EmbeddedSystemClass/FootlooseLogoController/SMC/ui.png

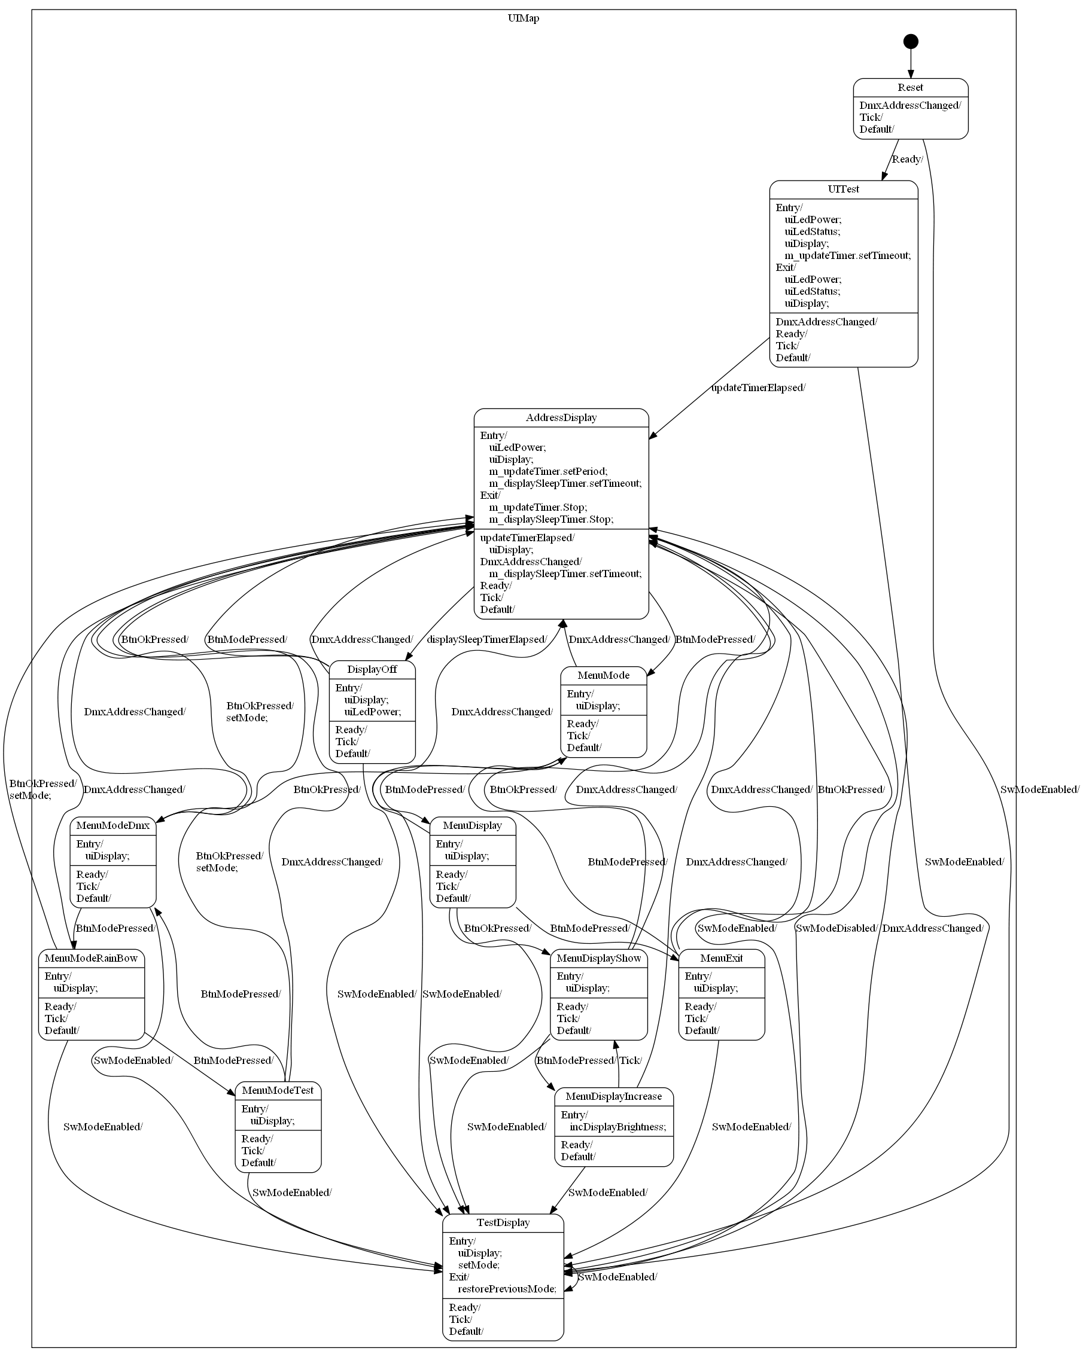
SMC/ui.png
