EmbeddedSystemClass/FootlooseLogoController/PCB/parts.xlsx

Sheet: controller
Partlist
Exported from controller pcb.sch at 25/02/2019 09:50
EAGLE Version 9.3.0 Copyright (c) 1988-2019 Autodesk, Inc.
Assembly variant:
Part | Value | Device | Package | Library | Sheet | farnell code | amount
C1, C2 | 22pF | C-EUC0603K | C0603K | rcl | 1 | 2533830
C3, C4, C5, C6, C7, C8, C12 | 100nF | C-EUC0603K | C0603K | rcl | 1 | 2522395
C9 | 2.2uF | C-EUC1206 | C1206 | rcl | 1 | 1458911
C10 | 22u | C-EUC1206 | C1206 | rcl | 1
C11 | No | C-EUC0603K | C0603K | rcl | 1
D1 | MBRA340T3 | MBRA340T3 | SMA | diode | 1
IC1, IC2, IC4 | MAX481CSA | MAX481CSA | SO08 | maxim | 1 | 2519249 (https://nl.farnell.com/maxim-integrated-products/max3483esa/ic-transceiver-rs422-rs485-8soic/dp/2519249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)
IC3 | STM32F303CCLQFP48 | STM32F303CCLQFP48 | LQFP48 | comp | 1 | 2215113
IC5 | TPS62177.DQC | TPS62177.DQC | DQC | packages(ti) | 1
L2 | LPS4018 | LPS4018 | LPS4018 | inductor-coilcraft | 1 | 2408076
LED1 |  | LEDCHIPLED_1206 | CHIPLED_1206 | led | 1 | 2099247 (https://nl.farnell.com/kingbright/kpt-3216sgc/led-1206-green-12mcd-568nm/dp/2099247)
LED2 |  | LEDCHIPLED_1206 | CHIPLED_1206 | led | 1 | 2290336 (https://nl.farnell.com/kingbright/kp-3216syck/led-1206-yellow/dp/2290336)
PROG | Header 4P | MA04-1 | MA04-1 | con-lstb | 1
Q1 | 8MHz | CRYSTALCTS406 | CTS406 | crystal | 1
R1, R2, R3, R4, R5, R6, R12, R13, R14 |  | R-EU_R0603 | R0603 | rcl | 1
R7 |  | R-EU_R0603 | R0603 | rcl | 1
R8 |  | R-EU_R0603 | R0603 | rcl | 1
R9 | 100K | R-EU_R0603 | R0603 | rcl | 1
R10, R11 | 100 | R-EU_R0603 | R0603 | rcl | 1
RN1, RN2, RN3 | 4K7 | 4R-NCAY16 | CAY16 | resistor-dil | 1 | 2321746
S1 |  | DIP10SB | DIP10SB | switch-dil | 1 | 2468732
SV1 | Header 6P | FE06-1 | FE06 | con-lsta | 1
X1, X5 | NC3FAH2-0 | NC3FAH2-0 | NC3FAH2-0 | con-neutrik_ag | 1
X2 | Boxed header 10p | -2510 | PAK100/2500-10 | con-3m | 1
X3 | Power 2P | AK500/2 | AK500/2 | con-ptr500 | 1
X4 | NC3MBH | NC3MBH | NC3MBH | con-neutrik_ag | 1

Sheet: ui
Partlist
Exported from ui.sch at 25/02/2019 09:51
EAGLE Version 9.3.0 Copyright (c) 1988-2019 Autodesk, Inc.
Assembly variant:
Part | Value | Device | Package | Library | Sheet | farnell code | amount
C1, C2 |  | C-EUC0603 | C0603 | rcl | 1
C3, C4, C5, C6 | 100nF | C-EUC0603 | C0603 | rcl | 1 | 2522395
D1 | KPTL-3216 | KPTL-3216 | LED-REV | comp | 1 | 2217905 (https://nl.farnell.com/kingbright/kptl-3216cgck-01/led-smd-1206-optic-green-reverse/dp/2217905)
D2 | KPTL-3216 | KPTL-3216 | LED-REV | comp | 1 | 2217904 (https://nl.farnell.com/kingbright/kptl-3216seck-01/led-smd-1206-optic-orange-reverse/dp/2217904)
IC1, IC2 | CAT9532 | CAT9532 | TQFN24-EP | comp | 1
IC3, IC4 | AT42QT1011 | AT42QT1011 | UDFN/USON_8_PAD | local_parts | 1
J1 | SMD 10p | 610X1021121 | 610X1021121 | Eagle_BOARD-TO-BOARD_CONNECTORS (rev18b) | 1
R1, R2 |  | R-EU_R0603 | R0603 | rcl | 1
R3, R4 |  | R-EU_R0603 | R0603 | rcl | 1
R5, R6, R7 | 4K7 | R-EU_R0603 | R0603 | rcl | 1
R8 |  | R-EU_R0603 | R0603 | rcl | 1
R9 |  | R-EU_R0603 | R0603 | rcl | 1
R10, R11, R12, R13, R14, R15 |  | 4R-NCAT16 | CAT16 | resistor-dil | 1
SEG1, SEG2, SEG3 | KCSA56-105 | KCSA56-105 | KCSA56-REV | comp | 1
