EmbeddedSystemClass/FootlooseLogoController/PCB/controller pcb.brd

## EAGLE design PCB/controller pcb.brd (2019-03-03)

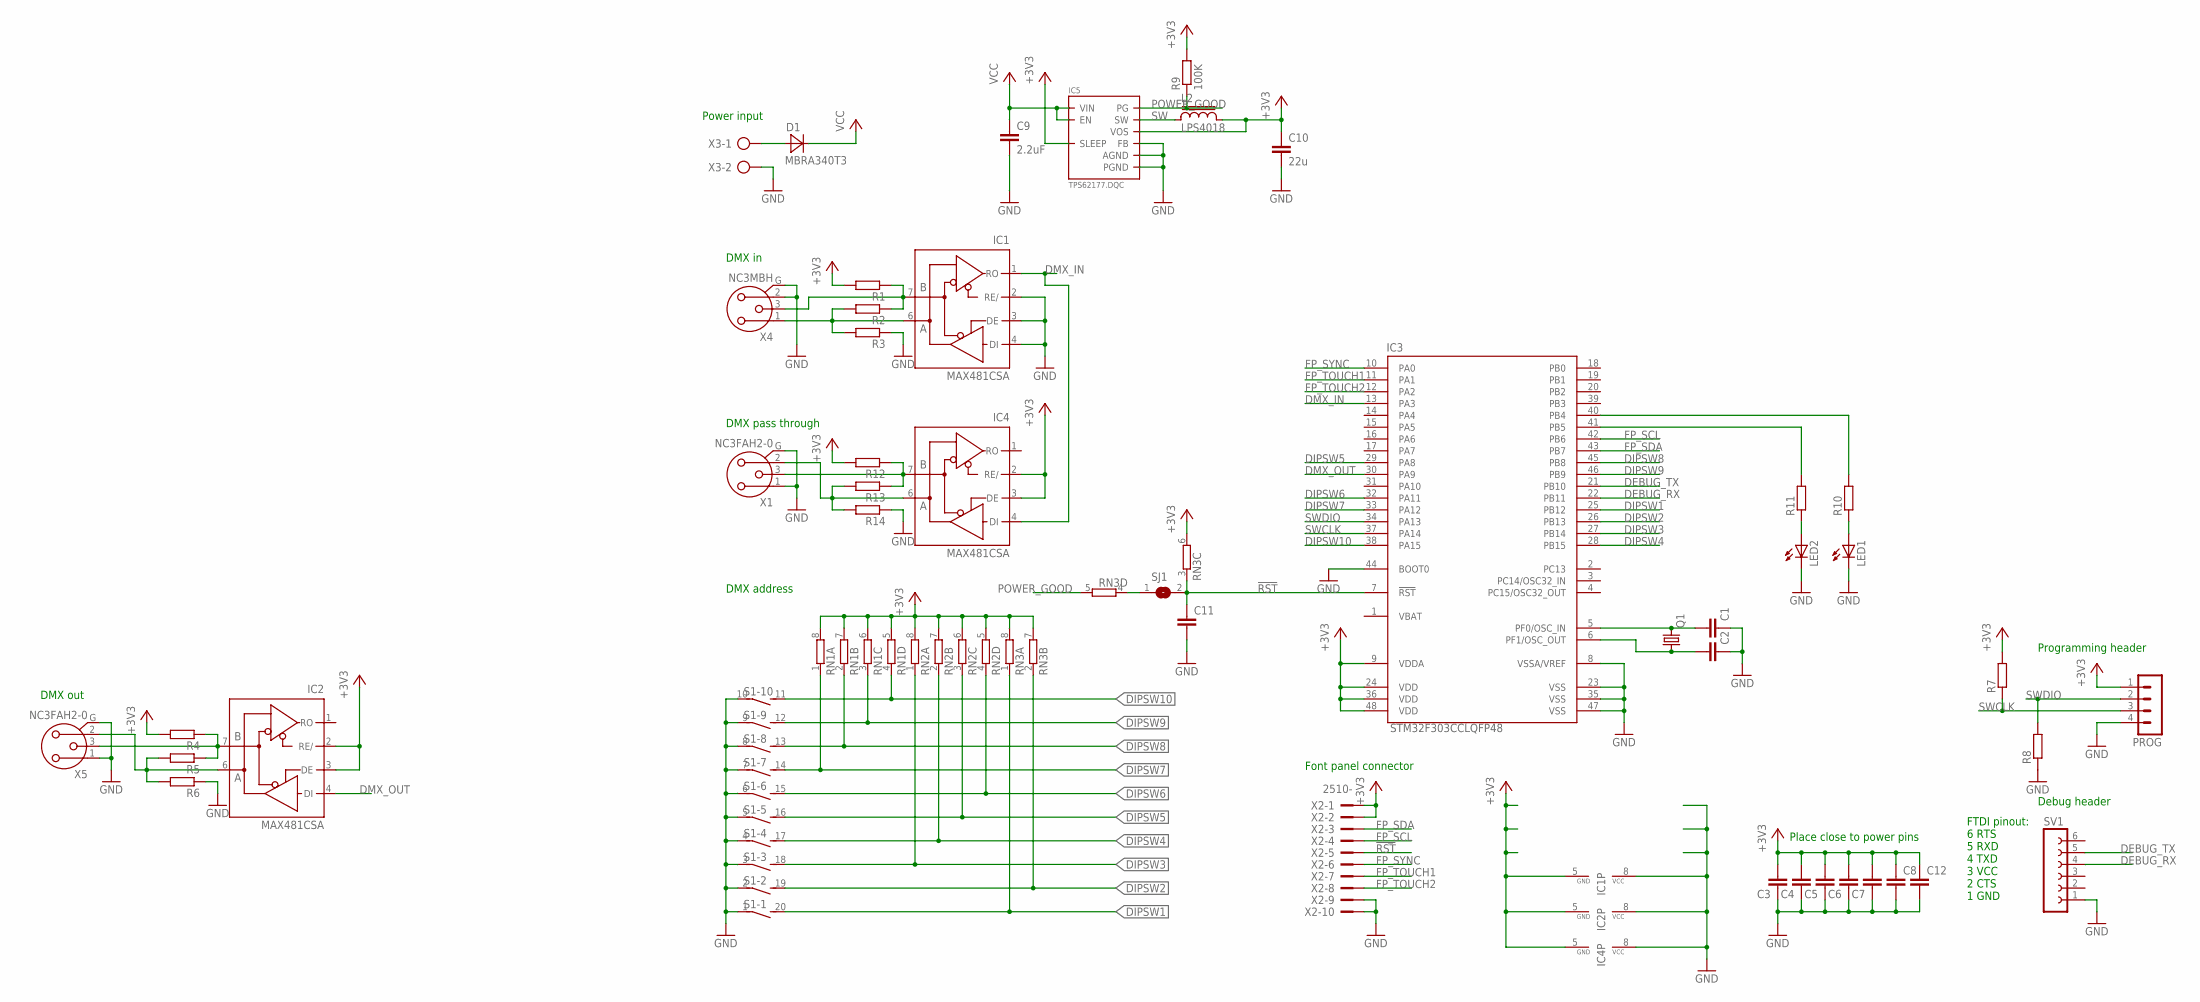
[picture p2: schematic controller pcb.sch]

Parts:
C1, C2, C3, C4, C5, C6, C7, C8, C11, C12: C-EUC0603K; C0603K
C9: 2.2uF; C1206
C10: 22u; C1206
D1: MBRA340T3; SMA
IC1, IC2, IC4: MAX481CSA; SO08
IC3: STM32F303CCLQFP48; LQFP48
IC5: TPS62177.DQC; DQC
L2: LPS4018
LED1, LED2: LEDCHIPLED_1206; CHIPLED_1206
PROG: MA04-1
Q1: CRYSTALCTS406; CTS406
R1, R2, R3, R4, R5, R6, R7, R8, R10, R11, R12, R13, R14: R-EU_R0603; R0603
R9: 100K; R0603
RN1, RN2, RN3: 4R-NCAY16; CAY16
S1: DIP10SB
SJ1: SJ
SV1: FE06-1; FE06
X1, X5: NC3FAH2-0
X2: 2510-; PAK100/2500-10
X3: AK500/2
X4: NC3MBH

Connections:
!RST: C11.1, IC3.7 (!RST), RN3.3 (1), SJ1.2, X2.5
+3V3: C3.2, C4.2, C5.2, C6.2, C7.2, C8.1, C10.1, C12.1, IC1.5 (GND), IC2.2 (RE/), IC2.3 (DE), IC2.5 (GND), IC3.9 (VDDA), IC3.24 (VDD), IC3.36 (VDD), IC3.48 (VDD), IC4.2 (RE/), IC4.3 (DE), IC4.5 (GND), IC5.8 (SLEEP), IC5.10 (VOS), L2.2, PROG.1, R1.2, R4.2, R7.2, R9.2, R12.2, RN1.5 (2), RN1.6 (2), RN1.7 (2), RN1.8 (2), RN2.5 (2), RN2.6 (2), RN2.7 (2), RN2.8 (2), RN3.6 (2), RN3.7 (2), RN3.8 (2), X2.1, X2.2
DEBUG_RX: IC3.22 (PB11), SV1.4
DEBUG_TX: IC3.21 (PB10), SV1.5
DIPSW1: IC3.25 (PB12), RN3.1, S1.20 (2)
DIPSW2: IC3.26 (PB13), RN3.2 (1), S1.19 (2)
DIPSW3: IC3.27 (PB14), RN2.1, S1.18 (2)
DIPSW4: IC3.28 (PB15), RN2.2 (1), S1.17 (2)
DIPSW5: IC3.29 (PA8), RN2.3 (1), S1.16 (2)
DIPSW6: IC3.32 (PA11), RN2.4 (1), S1.15 (2)
DIPSW7: IC3.33 (PA12), RN1.1, S1.14 (2)
DIPSW8: IC3.45 (PB8), RN1.2 (1), S1.13 (2)
DIPSW9: IC3.46 (PB9), RN1.3 (1), S1.12 (2)
DIPSW10: IC3.38 (PA15), RN1.4 (1), S1.11 (2)
DMX_IN: IC1.1 (RO), IC3.13 (PA3), IC4.4 (DI)
DMX_OUT: IC2.4 (DI), IC3.30 (PA9)
FP_SCL: IC3.42 (PB6), X2.4
FP_SDA: IC3.43 (PB7), X2.3
FP_SYNC: IC3.10 (PA0), X2.6
FP_TOUCH1: IC3.11 (PA1), X2.7
FP_TOUCH2: IC3.12 (PA2), X2.8
GND: C1.1, C2.1, C3.1, C4.1, C5.1, C6.1, C7.1, C8.2, C9.2, C10.2, C11.2, C12.2, IC1.2 (RE/), IC1.3 (DE), IC1.4 (DI), IC1.8 (VCC), IC2.8 (VCC), IC3.8 (VSSA/VREF), IC3.23 (VSS), IC3.35 (VSS), IC3.44 (BOOT0), IC3.47 (VSS), IC4.8 (VCC), IC5.1 (PGND), IC5.5 (FB), IC5.6 (AGND), IC5.PAD (PGND), LED1.C, LED2.C, PROG.4, R3.1, R6.1, R8.1, R14.1, S1.1, S1.2 (1), S1.3 (1), S1.4 (1), S1.5 (1), S1.6 (1), S1.7 (1), S1.8 (1), S1.9 (1), S1.10 (1), SV1.1, X1.1, X1.G, X2.9, X2.10, X3.2, X4.2, X4.G, X5.1, X5.G
unnamed: D1.A, X3.1
unnamed: IC4.6 (A), R13.2, R14.2, X1.2
unnamed: IC1.7 (B), R1.1, R2.1, X4.3
unnamed: C2.2, IC3.6 (PF1/OSC_OUT), Q1.1
unnamed: C1.2, IC3.5 (PF0/OSC_IN), Q1.3 (2)
unnamed: IC1.6 (A), R2.2, R3.2, X4.1
unnamed: IC2.6 (A), R5.2, R6.2, X5.2
unnamed: IC2.7 (B), R4.1, R5.1, X5.3
unnamed: LED1.A, R10.1
unnamed: LED2.A, R11.1
unnamed: IC4.7 (B), R12.1, R13.1, X1.3
unnamed: IC3.41 (PB5), R11.2
unnamed: IC3.40 (PB4), R10.2
unnamed: RN3.4 (1), SJ1.1
POWER_GOOD: IC5.7 (PG), R9.1, RN3.5 (2)
SW: IC5.9 (SW), L2.1
SWCLK: IC3.37 (PA14), PROG.3, R7.1
SWDIO: IC3.34 (PA13), PROG.2, R8.2
VCC: C9.1, D1.C, IC5.2 (VIN), IC5.3 (EN)

Notes on the sheet:
Power input
DMX in
DMX out
DMX address
Font panel connector
Place close to power pins
Debug header
FTDI pinout: 6 RTS 5 RXD 4 TXD 3 VCC 2 CTS 1 GND
Programming header
DMX pass through

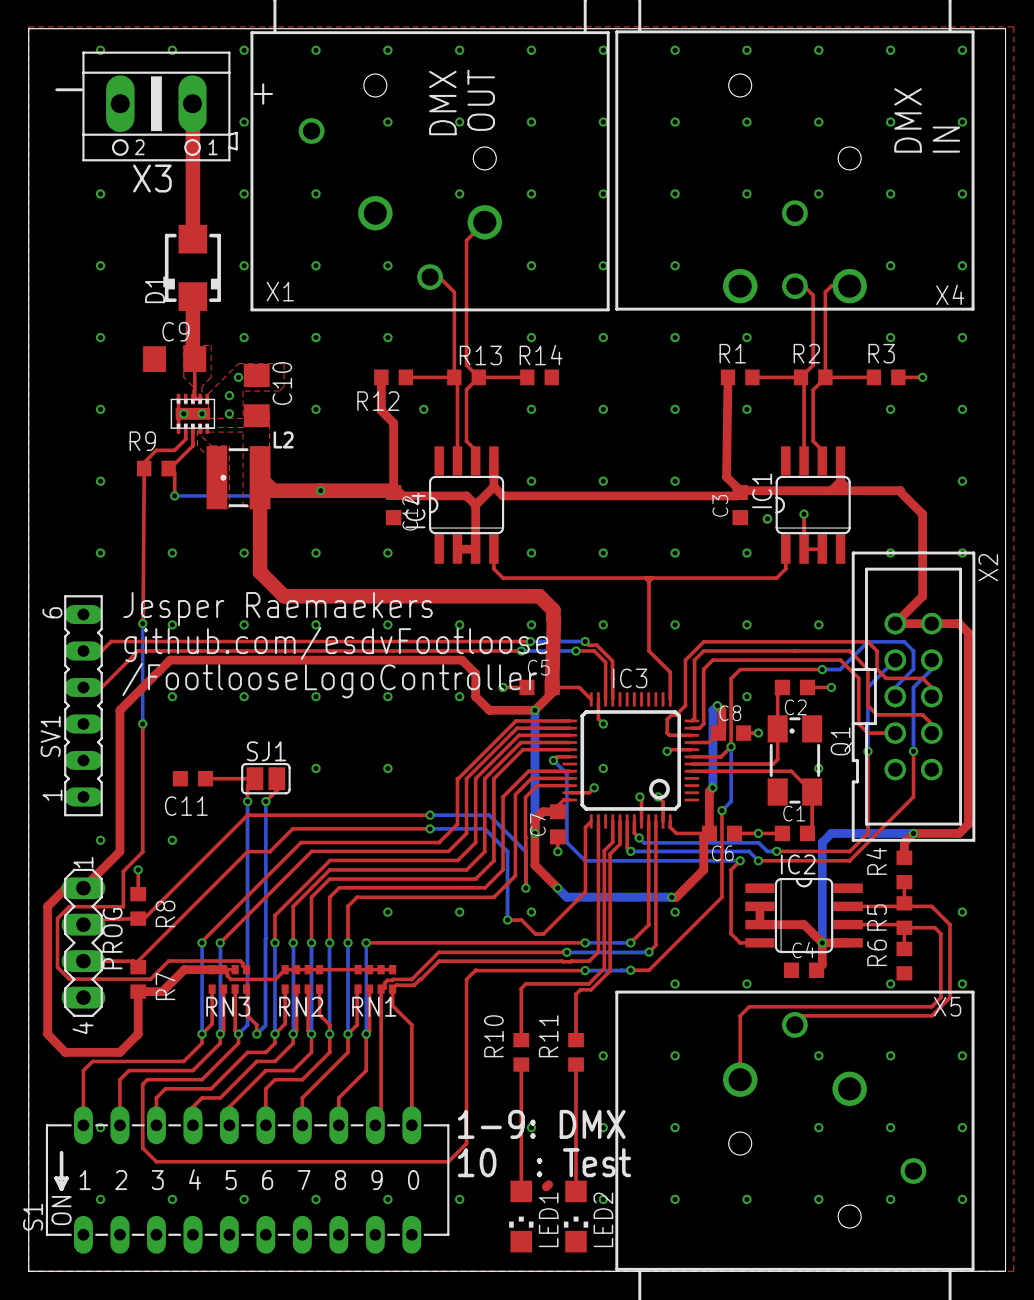
[picture p3: board controller pcb.brd from above]

Board: 2 copper layers, 68.0 x 86.5 mm, 48 parts (0 on the bottom side), 41 nets.
