EmbeddedSystemClass/FootlooseLogoController/PCB/ui.brd

## EAGLE design PCB/ui.brd (2019-03-03)

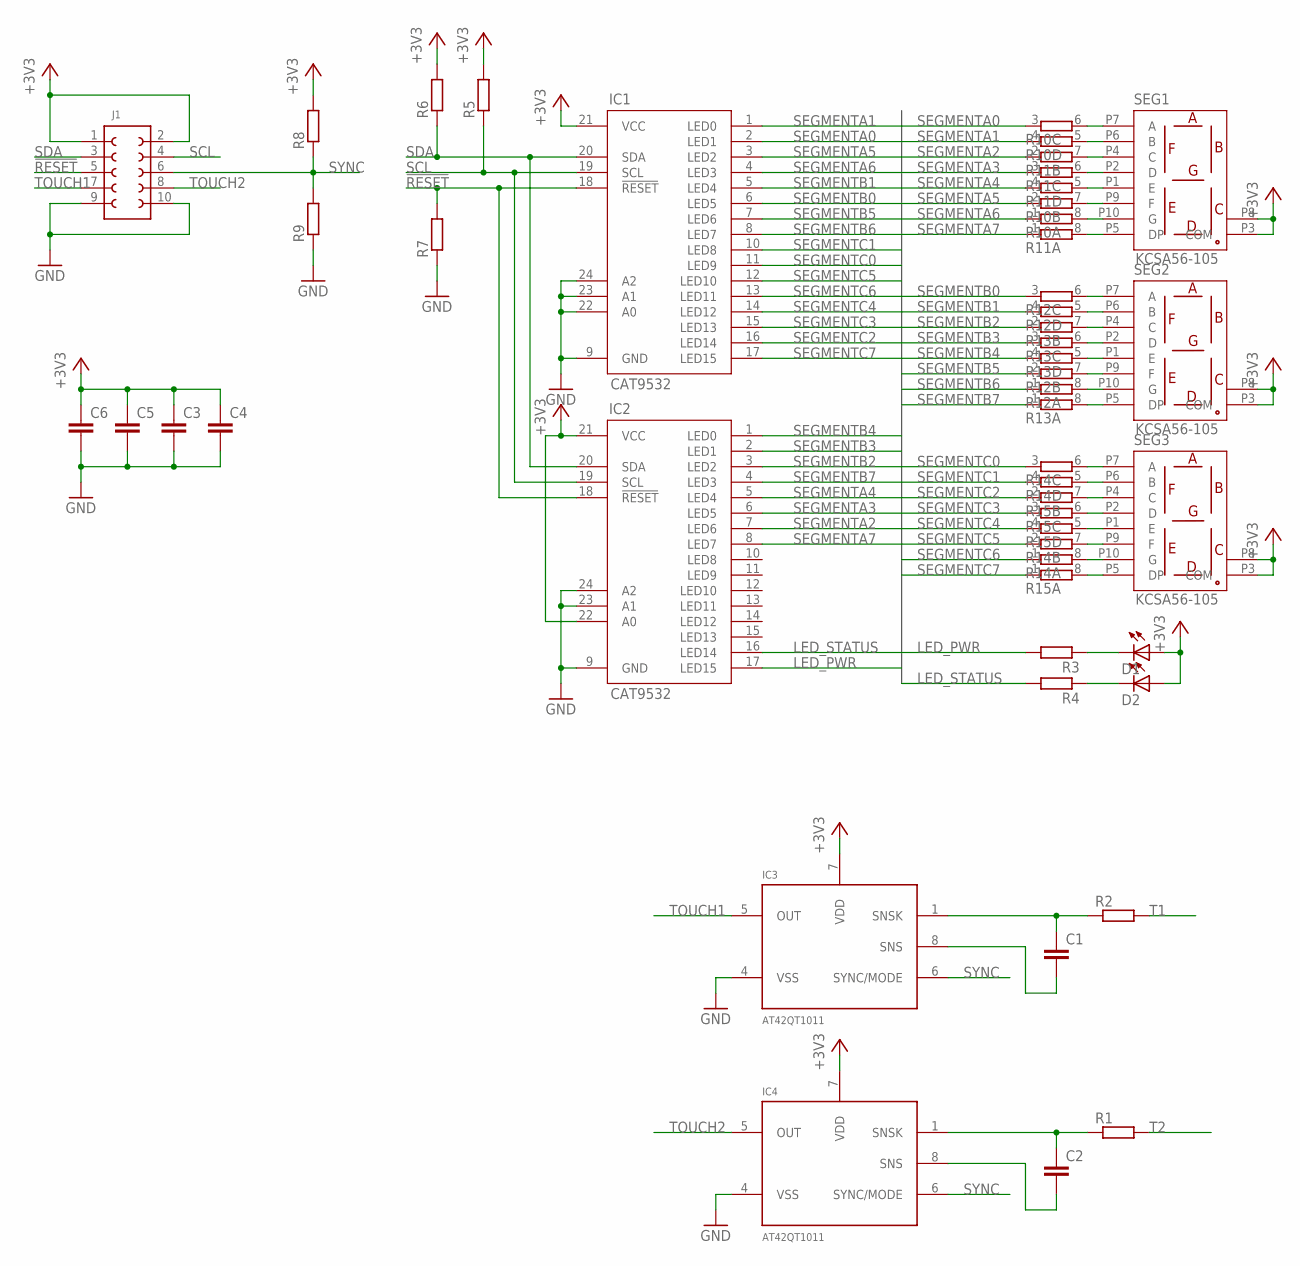
[picture p4: schematic ui.sch]

Parts:
C1, C2, C3, C4, C5, C6: C-EUC0603; C0603
D1, D2: KPTL-3216; LED-REV
IC1, IC2: CAT9532; TQFN24-EP
IC3, IC4: AT42QT1011; UDFN/USON_8_PAD
J1: 610X1021121
R1, R2, R3, R4, R5, R6, R7, R8, R9: R-EU_R0603; R0603
R10, R11, R12, R13, R14, R15: 4R-NCAT16; CAT16
SEG1, SEG2, SEG3: KCSA56-105; KCSA56-REV

Connections:
!RESET: IC1.18 (!RESET), IC2.18 (!RESET), J1.5 (3), R7.2
+3V3: C3.1, C4.1, C5.1, C6.1, D1.P$1 (A), D2.P$1 (A), IC1.21 (VCC), IC2.21 (VCC), IC2.22 (A0), IC3.7 (VDD), IC4.7 (VDD), J1.1, J1.2 (10), R5.2, R6.2, R8.2, SEG1.P3 (COM), SEG1.P8, SEG2.P3 (COM), SEG2.P8, SEG3.P3 (COM), SEG3.P8
GND: C3.2, C4.2, C5.2, C6.2, IC1.9 (GND), IC1.22 (A0), IC1.23 (A1), IC1.24 (A2), IC2.9 (GND), IC2.23 (A1), IC2.24 (A2), IC3.4 (VSS), IC4.4 (VSS), J1.9 (5), J1.10 (6), R7.1, R9.1
LED_PWR: IC2.17 (LED15), R3.2
LED_STATUS: IC2.16 (LED14), R4.2
unnamed: R10.8 (2), SEG1.P10 (G)
unnamed: R10.7 (2), SEG1.P9 (F)
unnamed: R10.6 (2), SEG1.P7 (A)
unnamed: R10.5 (2), SEG1.P6 (B)
unnamed: R12.8 (2), SEG2.P10 (G)
unnamed: R12.7 (2), SEG2.P9 (F)
unnamed: R12.6 (2), SEG2.P7 (A)
unnamed: R12.5 (2), SEG2.P6 (B)
unnamed: R14.8 (2), SEG3.P10 (G)
unnamed: R14.7 (2), SEG3.P9 (F)
unnamed: R14.6 (2), SEG3.P7 (A)
unnamed: R14.5 (2), SEG3.P6 (B)
unnamed: R11.8 (2), SEG1.P5 (DP)
unnamed: R11.7 (2), SEG1.P4 (C)
unnamed: R11.6 (2), SEG1.P2 (D)
unnamed: R11.5 (2), SEG1.P1 (E)
unnamed: R13.8 (2), SEG2.P5 (DP)
unnamed: R13.7 (2), SEG2.P4 (C)
unnamed: R13.6 (2), SEG2.P2 (D)
unnamed: R13.5 (2), SEG2.P1 (E)
unnamed: R15.8 (2), SEG3.P5 (DP)
unnamed: R15.7 (2), SEG3.P4 (C)
unnamed: R15.6 (2), SEG3.P2 (D)
unnamed: R15.5 (2), SEG3.P1 (E)
unnamed: C1.1, IC3.1 (SNSK), R2.1
unnamed: C1.2, IC3.8 (SNS)
unnamed: D1.P$2 (C), R3.1
unnamed: C2.1, IC4.1 (SNSK), R1.1
unnamed: C2.2, IC4.8 (SNS)
unnamed: D2.P$2 (C), R4.1
SCL: IC1.19 (SCL), IC2.19 (SCL), J1.4 (9), R5.1
SDA: IC1.20 (SDA), IC2.20 (SDA), J1.3 (2), R6.1
SEGMENTA0: IC1.2 (LED1), R10.3 (1)
SEGMENTA1: IC1.1 (LED0), R10.4 (1)
SEGMENTA2: IC2.7 (LED6), R11.2 (1)
SEGMENTA3: IC2.6 (LED5), R11.3 (1)
SEGMENTA4: IC2.5 (LED4), R11.4 (1)
SEGMENTA5: IC1.3 (LED2), R10.2 (1)
SEGMENTA6: IC1.4 (LED3), R10.1
SEGMENTA7: IC2.8 (LED7), R11.1
SEGMENTB0: IC1.6 (LED5), R12.3 (1)
SEGMENTB1: IC1.5 (LED4), R12.4 (1)
SEGMENTB2: IC2.3 (LED2), R13.2 (1)
SEGMENTB3: IC2.2 (LED1), R13.3 (1)
SEGMENTB4: IC2.1 (LED0), R13.4 (1)
SEGMENTB5: IC1.7 (LED6), R12.2 (1)
SEGMENTB6: IC1.8 (LED7), R12.1
SEGMENTB7: IC2.4 (LED3), R13.1
SEGMENTC0: IC1.11 (LED9), R14.3 (1)
SEGMENTC1: IC1.10 (LED8), R14.4 (1)
SEGMENTC2: IC1.16 (LED14), R15.2 (1)
SEGMENTC3: IC1.15 (LED13), R15.3 (1)
SEGMENTC4: IC1.14 (LED12), R15.4 (1)
SEGMENTC5: IC1.12 (LED10), R14.2 (1)
SEGMENTC6: IC1.13 (LED11), R14.1
SEGMENTC7: IC1.17 (LED15), R15.1
SYNC: IC3.6 (SYNC/MODE), IC4.6 (SYNC/MODE), J1.6 (8), R8.1, R9.2
T1: R2.2
T2: R1.2
TOUCH1: IC3.5 (OUT), J1.7 (4)
TOUCH2: IC4.5 (OUT), J1.8 (7)

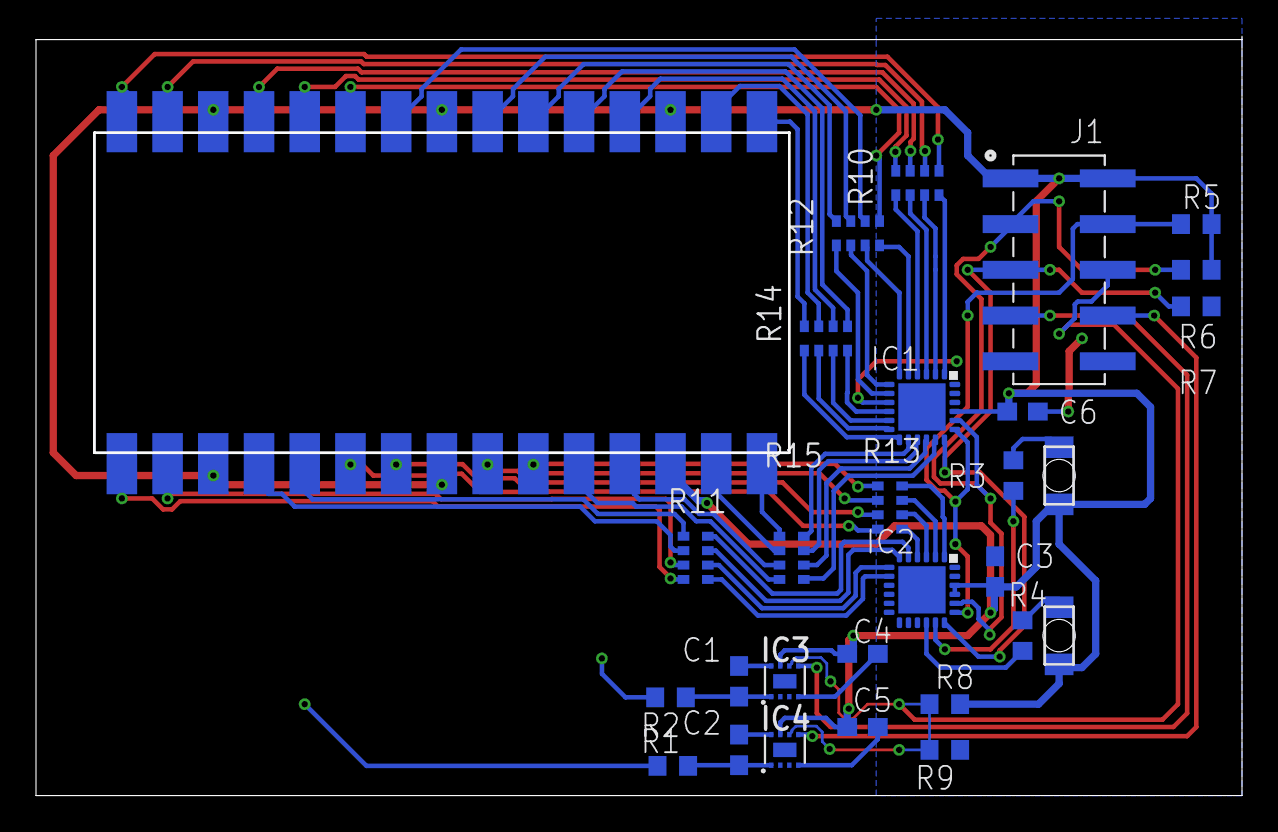
[picture p5: board ui.brd from below]

Board: 2 copper layers, 67.0 x 42.0 mm, 31 parts (26 on the bottom side), 64 nets.
