EmbeddedSystemClass/FootlooseLogoController/src/main.cpp

/**
 ******************************************************************************
 * File Name          : main.c
 * Description        : Main program body
 ******************************************************************************
 * This notice applies to any and all portions of this file
 * that are not between comment pairs USER CODE BEGIN and
 * USER CODE END. Other portions of this file, whether
 * inserted by the user or by software development tools
 * are owned by their respective copyright owners.
 *
 * Copyright (c) 2018 STMicroelectronics International N.V.
 * All rights reserved.
 *
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
 ******************************************************************************
 */
/* Includes ------------------------------------------------------------------*/

#include "main.h"

#include "app/BSP.h"
extern "C"
{
#include "cmsis_os.h"
#include "stm32f3xx_hal.h"
#include "task.h"
    //#include "usb_device.h"
    //#include "usbd_cdc_if.h"
}

I2C_HandleTypeDef hi2c1;
DMA_HandleTypeDef hdma_i2c1_tx;

TIM_HandleTypeDef htim2;

UART_HandleTypeDef huart1;
UART_HandleTypeDef huart2;
UART_HandleTypeDef huart3;

osThreadId defaultTaskHandle;

/* USER CODE BEGIN PV */

/* USER CODE END PV */

void        SystemClock_Config(void);
static void MX_GPIO_Init(void);
// static void MX_USART2_UART_Init(void);
// static void MX_USART1_UART_Init(void);
// static void MX_I2C1_Init(void);
void StartDefaultTask(void const* argument);

/* USER CODE BEGIN PFP */

/* USER CODE END PFP */

int main(void)
{

    /* MCU
     * Configuration----------------------------------------------------------*/

    /* Reset of all peripherals, Initializes the Flash interface and the
     * Systick. */
    HAL_Init();

    /* Configure the system clock */
    SystemClock_Config();

    /* Initialize all configured peripherals */
    MX_GPIO_Init();

    //    MX_USART2_UART_Init();
    //    MX_USART1_UART_Init();

    /* USER CODE BEGIN RTOS_MUTEX */
    /* add mutexes, ... */
    /* USER CODE END RTOS_MUTEX */

    /* USER CODE BEGIN RTOS_SEMAPHORES */
    /* add semaphores, ... */
    /* USER CODE END RTOS_SEMAPHORES */

    /* USER CODE BEGIN RTOS_TIMERS */
    /* start timers, add new ones, ... */
    /* USER CODE END RTOS_TIMERS */

    /* Create the thread(s) */
    /* definition and creation of defaultTask */
#pragma GCC diagnostic ignored "-Wwrite-strings"
    osThreadDef(defaultTask, StartDefaultTask, osPriorityNormal, 0, 128);
    defaultTaskHandle = osThreadCreate(osThread(defaultTask), NULL);
#pragma GCC diagnostic pop
    /* USER CODE BEGIN RTOS_THREADS */
    /* add threads, ... */
    BSP bsp("BSP");

    bsp.Start();
    /* USER CODE END RTOS_THREADS */

    /* USER CODE BEGIN RTOS_QUEUES */
    /* add queues, ... */
    /* USER CODE END RTOS_QUEUES */

    /* Start scheduler */
    osKernelStart();

    /* We should never get here as control is now taken by the scheduler */

    /* Infinite loop */
    /* USER CODE BEGIN WHILE */
    while (1)
    {
        /* USER CODE END WHILE */

        /* USER CODE BEGIN 3 */
    }
    /* USER CODE END 3 */
}

/** System Clock Configuration
 */
void SystemClock_Config(void)
{

    RCC_OscInitTypeDef       RCC_OscInitStruct;
    RCC_ClkInitTypeDef       RCC_ClkInitStruct;
    RCC_PeriphCLKInitTypeDef PeriphClkInit;

    /**Initializes the CPU, AHB and APB busses clocks
     */
    RCC_OscInitStruct.OscillatorType = RCC_OSCILLATORTYPE_HSE;
    RCC_OscInitStruct.HSEState       = RCC_HSE_ON;
    RCC_OscInitStruct.HSEPredivValue = RCC_HSE_PREDIV_DIV1;
    RCC_OscInitStruct.HSIState       = RCC_HSI_ON;
    RCC_OscInitStruct.PLL.PLLState   = RCC_PLL_ON;
    RCC_OscInitStruct.PLL.PLLSource  = RCC_PLLSOURCE_HSE;
    RCC_OscInitStruct.PLL.PLLMUL     = RCC_PLL_MUL9;
    if (HAL_RCC_OscConfig(&RCC_OscInitStruct) != HAL_OK)
    {
        _Error_Handler(__FILE__, __LINE__);
    }

    /**Initializes the CPU, AHB and APB busses clocks
     */
    RCC_ClkInitStruct.ClockType      = RCC_CLOCKTYPE_HCLK | RCC_CLOCKTYPE_SYSCLK | RCC_CLOCKTYPE_PCLK1 | RCC_CLOCKTYPE_PCLK2;
    RCC_ClkInitStruct.SYSCLKSource   = RCC_SYSCLKSOURCE_PLLCLK;
    RCC_ClkInitStruct.AHBCLKDivider  = RCC_SYSCLK_DIV1;
    RCC_ClkInitStruct.APB1CLKDivider = RCC_HCLK_DIV2;
    RCC_ClkInitStruct.APB2CLKDivider = RCC_HCLK_DIV1;

    if (HAL_RCC_ClockConfig(&RCC_ClkInitStruct, FLASH_LATENCY_2) != HAL_OK)
    {
        _Error_Handler(__FILE__, __LINE__);
    }

    PeriphClkInit.PeriphClockSelection = RCC_PERIPHCLK_USART1 | RCC_PERIPHCLK_USART2 | RCC_PERIPHCLK_USART3;
    PeriphClkInit.Usart1ClockSelection = RCC_USART1CLKSOURCE_PCLK2;
    PeriphClkInit.Usart2ClockSelection = RCC_USART2CLKSOURCE_SYSCLK;
    PeriphClkInit.Usart3ClockSelection = RCC_USART3CLKSOURCE_SYSCLK;
    if (HAL_RCCEx_PeriphCLKConfig(&PeriphClkInit) != HAL_OK)
    {
        _Error_Handler(__FILE__, __LINE__);
    }

    /**Configure the Systick interrupt time
     */
    HAL_SYSTICK_Config(HAL_RCC_GetHCLKFreq() / 1000);

    /**Configure the Systick
     */
    HAL_SYSTICK_CLKSourceConfig(SYSTICK_CLKSOURCE_HCLK);

    /* SysTick_IRQn interrupt configuration */
    HAL_NVIC_SetPriority(SysTick_IRQn, 15, 0);
}

/**
 * @brief I2C1 Initialization Function
 * @param None
 * @retval None
 */
// static void MX_I2C1_Init(void)
//{
//
//    /* USER CODE BEGIN I2C1_Init 0 */
//
//    /* USER CODE END I2C1_Init 0 */
//
//    /* USER CODE BEGIN I2C1_Init 1 */
//
//    /* USER CODE END I2C1_Init 1 */
//    hi2c1.Instance              = I2C1;
//    hi2c1.Init.Timing           = 0x2000090E;
//    hi2c1.Init.OwnAddress1      = 0;
//    hi2c1.Init.AddressingMode   = I2C_ADDRESSINGMODE_7BIT;
//    hi2c1.Init.DualAddressMode  = I2C_DUALADDRESS_DISABLE;
//    hi2c1.Init.OwnAddress2      = 0;
//    hi2c1.Init.OwnAddress2Masks = I2C_OA2_NOMASK;
//    hi2c1.Init.GeneralCallMode  = I2C_GENERALCALL_DISABLE;
//    hi2c1.Init.NoStretchMode    = I2C_NOSTRETCH_DISABLE;
//    if (HAL_I2C_Init(&hi2c1) != HAL_OK)
//    {
//        Error_Handler();
//    }
//    /** Configure Analogue filter
//     */
//    if (HAL_I2CEx_ConfigAnalogFilter(&hi2c1, I2C_ANALOGFILTER_ENABLE) != HAL_OK)
//    {
//        Error_Handler();
//    }
//    /** Configure Digital filter
//     */
//    if (HAL_I2CEx_ConfigDigitalFilter(&hi2c1, 0) != HAL_OK)
//    {
//        Error_Handler();
//    }
//    /* USER CODE BEGIN I2C1_Init 2 */
//
//    /* USER CODE END I2C1_Init 2 */
//}

/**
 * Enable DMA controller clock
 */
// static void MX_DMA_Init(void)
//{
//    /* DMA controller clock enable */
//    __HAL_RCC_DMA1_CLK_ENABLE();
//
//    /* DMA interrupt init */
//    /* DMA1_Channel6_IRQn interrupt configuration */
//    HAL_NVIC_SetPriority(DMA1_Channel6_IRQn, 5, 0);
//    HAL_NVIC_EnableIRQ(DMA1_Channel6_IRQn);
//}

/* USART1 init function */
// static void MX_USART1_UART_Init(void)
//{
//
//    huart1.Instance          = USART1;
//    huart1.Init.BaudRate     = 115200;
//    huart1.Init.WordLength   = UART_WORDLENGTH_8B;
//    huart1.Init.StopBits     = UART_STOPBITS_1;
//    huart1.Init.Parity       = UART_PARITY_NONE;
//    huart1.Init.Mode         = UART_MODE_TX_RX;
//    huart1.Init.HwFlowCtl    = UART_HWCONTROL_NONE;
//    huart1.Init.OverSampling = UART_OVERSAMPLING_16;
//    if (HAL_UART_Init(&huart1) != HAL_OK)
//    {
//        _Error_Handler(__FILE__, __LINE__);
//    }
//}

/* USART2 init function */
// static void MX_USART2_UART_Init(void)
//{
//
//    huart2.Instance          = USART2;
//    huart2.Init.BaudRate     = 115200;
//    huart2.Init.WordLength   = UART_WORDLENGTH_8B;
//    huart2.Init.StopBits     = UART_STOPBITS_1;
//    huart2.Init.Parity       = UART_PARITY_NONE;
//    huart2.Init.Mode         = UART_MODE_TX_RX;
//    huart2.Init.HwFlowCtl    = UART_HWCONTROL_NONE;
//    huart2.Init.OverSampling = UART_OVERSAMPLING_16;
//    if (HAL_UART_Init(&huart2) != HAL_OK)
//    {
//        _Error_Handler(__FILE__, __LINE__);
//    }
//}

/** Configure pins as
 * Analog
 * Input
 * Output
 * EVENT_OUT
 * EXTI
 */
static void MX_GPIO_Init(void)
{

    /* GPIO Ports Clock Enable */
    __HAL_RCC_GPIOC_CLK_ENABLE();
    __HAL_RCC_GPIOD_CLK_ENABLE();
    __HAL_RCC_GPIOA_CLK_ENABLE();
    __HAL_RCC_GPIOB_CLK_ENABLE();
}

/* StartDefaultTask function */
void StartDefaultTask(void const* argument)
{
    (void)argument;
    /* init code for USB_DEVICE */
    //   MX_USB_DEVICE_Init();
    //    HAL_I2C_Init(&hi2c1);
    /* USER CODE BEGIN 5 */
    //    uint8_t data[8] = {0b10110, 0b01010101, 0b01010101, 0b01010101, 0b01010101};
    /* Infinite loop */
    for (;;)
    {
        //        HAL_I2C_Master_Transmit_IT(&hi2c1, 0b11000000, (uint8_t*)&data, 8);
        //        osDelay(1);
        //        HAL_I2C_Master_Transmit_IT(&hi2c1, 0b11000010, (uint8_t*)&data, 8);
        osDelay(500);
    }
    /* USER CODE END 5 */
}

/**
 * @brief  Period elapsed callback in non blocking mode
 * @note   This function is called  when TIM1 interrupt took place, inside
 * HAL_TIM_IRQHandler(). It makes a direct call to HAL_IncTick() to increment
 * a global variable "uwTick" used as application time base.
 * @param  htim : TIM handle
 * @retval None
 */
void HAL_TIM_PeriodElapsedCallback(TIM_HandleTypeDef* htim)
{
    if (htim->Instance == TIM1)
    {
        HAL_IncTick();
    }
}

/**
 * @brief  This function is executed in case of error occurrence.
 * @param  None
 * @retval None
 */
void _Error_Handler(const char* file, int line)
{
    (void)file;
    (void)line;
    /* USER CODE BEGIN Error_Handler_Debug */
    /* User can add his own implementation to report the HAL error return state
     */
    while (1)
    {
    }
    /* USER CODE END Error_Handler_Debug */
}

#ifdef USE_FULL_ASSERT

/**
 * @brief Reports the name of the source file and the source line number
 * where the assert_param error has occurred.
 * @param file: pointer to the source file name
 * @param line: assert_param error line source number
 * @retval None
 */
void assert_failed(char* file, uint32_t line)
{
    /* USER CODE BEGIN 6 */
    (void)file;
    (void)line;
    /* User can add his own implementation to report the file name and line
      number,
      ex: printf("Wrong parameters value: file %s on line %d\r\n", file, line)
      */
    /* USER CODE END 6 */
}

#endif

/**
 * @}
 */

void HardFault_Handler()
{
    for (;;)
    {
    }
}
/**
 * @}
 */

/************************ (C) COPYRIGHT STMicroelectronics *****END OF FILE****/
