EmbeddedSystemClass/FootlooseLogoController/src/app/TaskStateMonitor.cpp

/*************************************************
 * @file TaskStateMonitor.cpp
 * @brief Task state monitor
 *
 *************************************************/
#include "stdint.h"

#include "OSError.h"
#include "app/TaskState.h"
#include "app/TaskStateMonitor.h"
#include "drv/DRVGPIO.h"
#include "thread.hpp"

TaskStateMonitor::TaskStateMonitor(const char* name, GPIOBlinker& led)
    : cpp_freertos::Thread(name, 250, 2)
    , m_led(led)
    , m_lastHighestState(TaskState::TaskStateNone)
{
    for (uint8_t ii = 0; ii < 16; ii++) m_taskStates[ii] = TaskState::TaskStateNone;
}

TaskStateMonitor::~TaskStateMonitor() {}

void TaskStateMonitor::Run()
{

    while (1)
    {
        uint32_t         notificationValue = 0;
        TaskState::State highestState      = TaskState::TaskStateNone;
        // wait for notification
        WaitForNotification(&notificationValue);

        if (notificationValue)
        {
            uint8_t ID = (notificationValue >> 16) & 0xFF;
            if (ID < 16)
            {
                m_taskStates[ID] = static_cast<TaskState::State>(notificationValue & 0xFFFF);
            }
            else
            {
                REPORTLOG("ID higher than 16 received")
            }

            highestState = getHighestState();
            if (highestState != m_lastHighestState)
            {
                switch (highestState)
                {
                case TaskState::TaskStateError:
                    m_led.setDutyCycle(20);
                    m_led.setFrequency(10);
                    break;
                case TaskState::TaskStateRunning:
                    m_led.setDutyCycle(80);
                    m_led.setFrequency(2);
                    break;
                case TaskState::TaskStateWaiting:
                    m_led.setDutyCycle(10);
                    m_led.setFrequency(2);
                    break;
                case TaskState::TaskStateInit:
                    m_led = true;
                    break;
                case TaskState::TaskStateNone:
                default:
                    m_led = false;
                    break;
                }
                m_lastHighestState = highestState;
            }
        }
    }
}

TaskState::State TaskStateMonitor::getHighestState()
{
    TaskState::State retVal = TaskState::TaskStateNone;

    for (uint8_t ii = 0; ii < 16; ii++)
    {
        if (static_cast<uint8_t>(m_taskStates[ii]) > static_cast<uint8_t>(retVal))
        {
            retVal = m_taskStates[ii];
        }
    }

    return retVal;
}
