EmbeddedSystemClass/FootlooseLogoController/(commit log)

2018-10-09 Created serial driver concept
2018-11-09 Updated OSerror and drivers to use new semaphore
2018-11-12 Added driver for GPIO
2018-11-12 Added template for uart on STM32F103C8
2018-11-13 Added output blinker class. Updated cubemx project to enable software timers
2018-11-13 Created monitoring for future tasks to output on LED
2018-11-13 Started DMX receiver with rework of HAL uart
    [BSP.cpp, HALUartSTM32F1.cpp]
2018-11-19 Added test effects and fixture sorting
    [EffectsController.cpp, FixtureBase.cpp]
2018-11-20 HAL uart can now send and receive data
2018-11-23 Timer interrupts working
2018-11-27 Adding timer to dmx receiver
2018-11-27 Added hal timer files
2018-11-27 Timer somewhat working, some values returning. fixed a seemingly simply mistake in hal files
    [BSP.cpp, DMXReceiver.cpp, HALTimerSTM32F1.cpp, main.cpp]
2018-11-28 Set correct prescaler for timer
    [DMXReceiver.cpp, HALTimerSTM32F1.cpp]
2018-12-05 Initial commit of controller pcb
    [controller pcb.brd, controller pcb.sch]
2018-12-09 Changed timer detection 3<>4 for correct edge detection
    [BSP.cpp, DMXReceiver.cpp, HALTimerSTM32F1.cpp]
2018-12-11 added user interface pcb files
    [ui.brd, ui.sch]
2018-12-12 UI PCB finished and slickscreen checked
    [ui.brd, ui.sch]
2018-12-17 Minor changes to fron PCB. changed positioning of segments and buttons
    [controller pcb.brd, controller pcb.sch, ui.brd]
2019-02-10 pending changes...
    [controller pcb.brd, controller pcb.sch]
2019-02-12 Updated to STM32f303
    [controller pcb.brd, controller pcb.sch]
2019-02-13 Placed extra decoupling cap and cleaned up some routing
    [controller pcb.brd, controller pcb.sch]
2019-02-19 Finalized PCBs
    [controller pcb.brd, controller pcb.sch]
2019-02-27 PCB parts list
    [parts.xlsx]
2019-03-03 Porting to STM32f303CC. already changed in cubemx file
2019-03-03 Running on STM32F303
2019-03-03 Added power and status LEDs to BSP
2019-03-03 Corrected pin for LEDs
    [BSP.cpp]
2019-03-16 Added missing interrupt handlers, changes task monitor led output. regenerated cubemx files with new version of cubemx
    [BSP.cpp, DMXTransmitter.cpp, EffectsController.cpp, GPIOBlinker.cpp, TaskStateMonitor.cpp]
2019-03-17 Added I2C drivers and remote IO
2019-03-17 Added 7 segment driver
2019-04-28 Reworked timer and callback system
    [BSP.cpp, DRV7SegmentDisplay.cpp, UserInterface.cpp]
2019-04-28 Resolved stack overflow in BSP and fixed pinout for dipswitches
    [BSP.cpp, DRV7SegmentDisplay.cpp, EffectsController.cpp, UserInterface.cpp, cubemx.ioc, mem.c]
2019-05-01 Fixed UI IO mapping and added offset to bintodec converter
    [BSP.cpp, BinDecIO.cpp, CAT5932.cpp]
2019-05-02 Added semsaphore to I2C hal and auto update to the led drivers
2019-05-04 add brightness capability to driver and ui
2019-05-05 gpioduplicate not working yet
    [BSP.cpp, CAT5932.cpp, GPIOOutputDuplicate.cpp]
2019-05-05 GPIO duplicate was OK led driver toggle method was faulty
2019-05-19 Reverted removal of default task
    [main.cpp]
