EmbeddedSystemClass/FootlooseLogoController/(notices)

Notices in the files:
parts and their libraries:
Eagle_BOARD-TO-BOARD_CONNECTORS: Copyright: Würth Elektronik
